ianm8/uPDCR/README.md

# uPDCR
A simple direct conversion receiver using the phasing method of image rejection. This is an evolution of the uDCR and the uDCR2 receivers. This radio tunes from 3.5 MHz to 15 MHz and receives signals modulated with LSB, USB or CW.

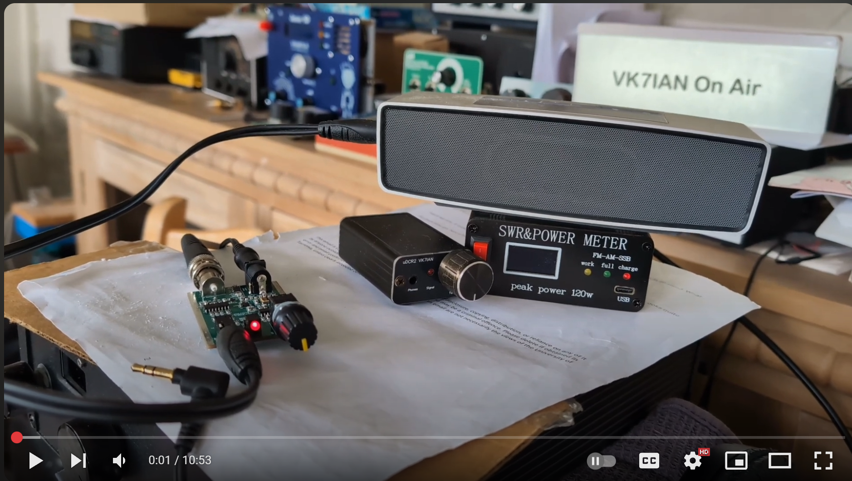
[picture p1: docs/uPDCR-Example-Video.png]
IMAGE ALT TEXT HERE (https://www.youtube.com/watch?v=nOgAh_WVSGE)
