ianm8/uPDCR/src/README.md

Build:
 * Board: Seeed XIAO RP2350 
 * CPU Speed: 240Mhz
 * Optimize: -O2
 * USB Stack: No USB
 * Flash Size: 2MB

Some history
 * Version 0.9 initial release
 * Version 1.0 fix random LSB/USB changes
 * Version 1.1 2025-03-26 improve band change muting
 * Version 1.2 2025-03-29 tweak to S-meter parameters
