ianm8/uPDCR/docs/uPDCR-Filter-PCB.jpg

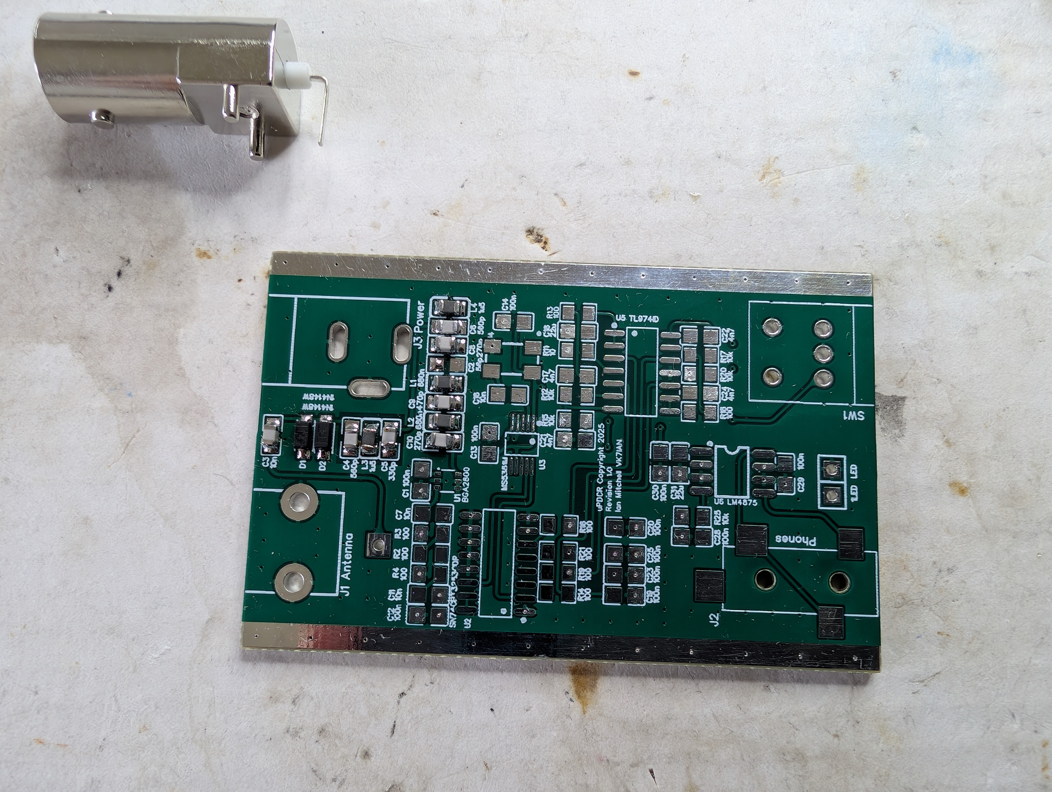
docs/uPDCR-Filter-PCB.jpg
