ianm8/uPDCR/docs/uPDCR-Filter-Response.jpg

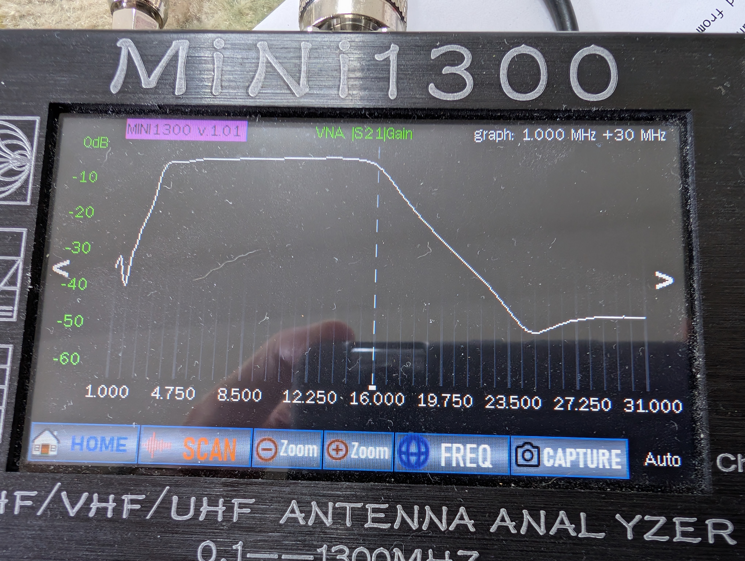
docs/uPDCR-Filter-Response.jpg
