ianm8/uPDCR/docs/uPDCR-QSD-DSO.jpg

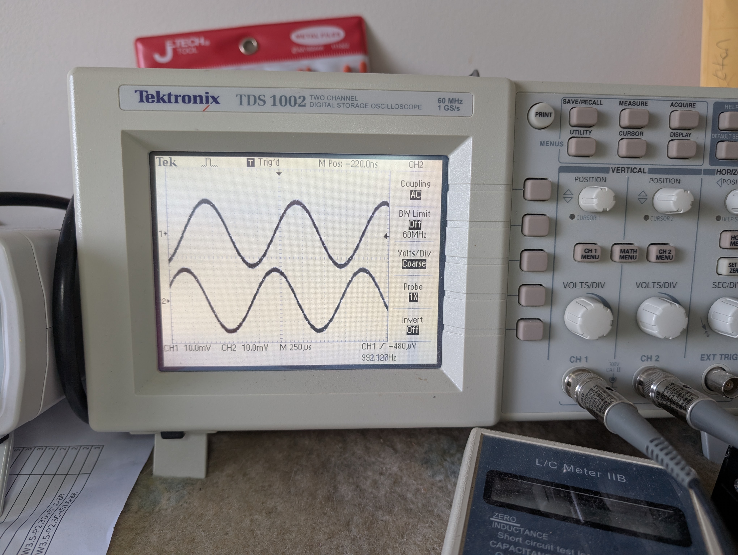
docs/uPDCR-QSD-DSO.jpg
