ianm8/uPDCR/docs/uPDCR-QSD-PCB.jpg

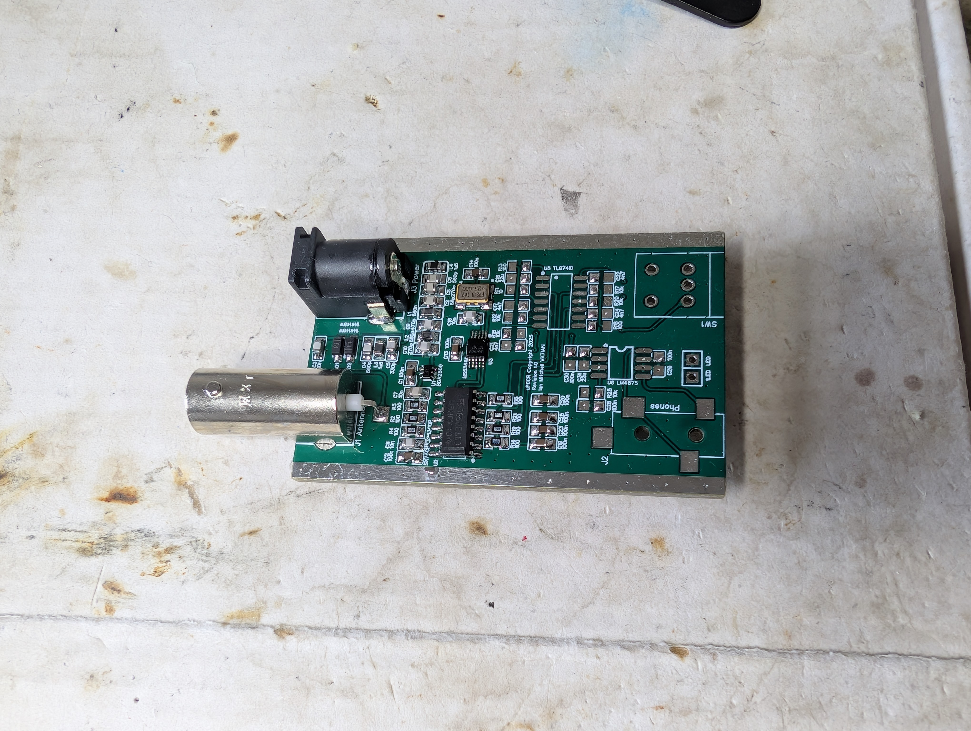
docs/uPDCR-QSD-PCB.jpg
