ianm8/uPDCR/docs/Schematic_uPDCR_2025-03-05.pdf

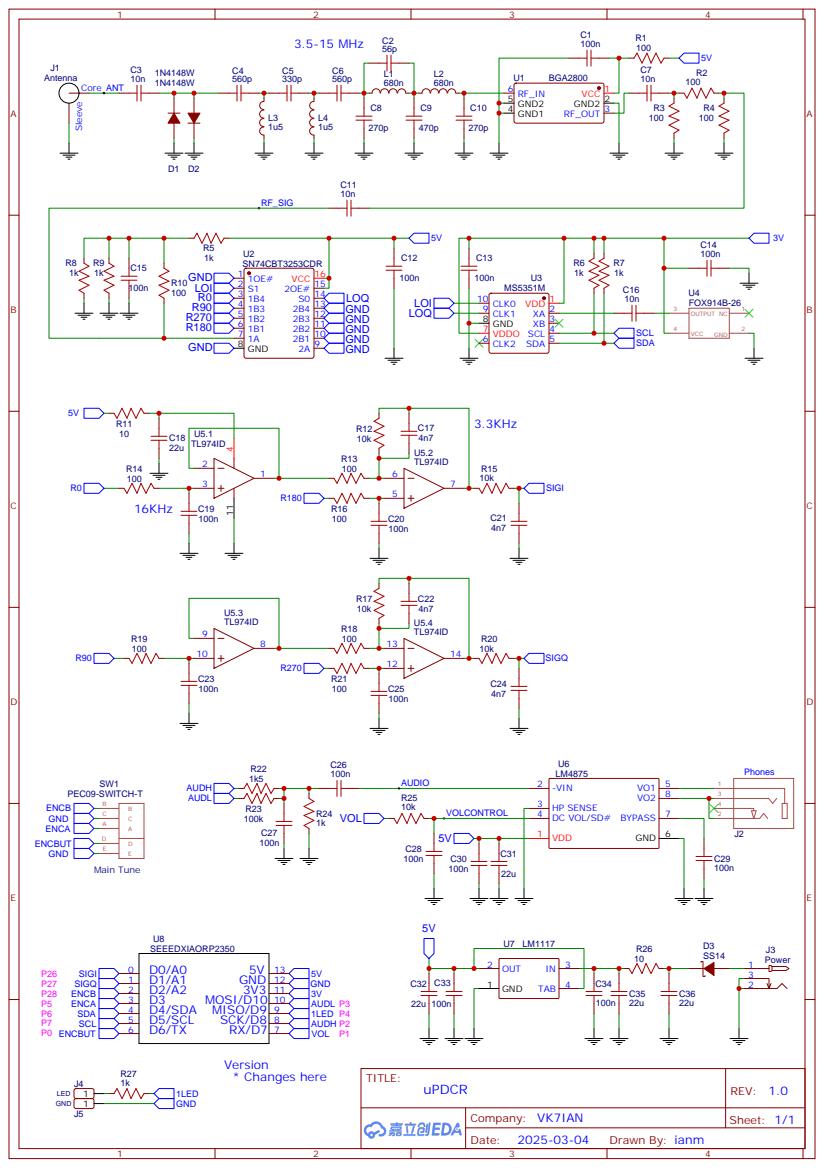
[picture p6: page 1]
