ianm8/uPDCR/src/filter.h

/*
 * uPDCR - Direct Conversion Receiver mk III
 *
 * Copyright (C) 2025 Ian Mitchell VK7IAN
 *
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
 * You should have received a copy of the GNU General Public License
 * along with this program.  If not, see <http://www.gnu.org/licenses/>.
 */

#ifndef FILTER_H
#define FILTER_H

#define FIR_LENGTH 256
#define __mac_tap(_h) acc += (_h)*x[i++]
#define __mac_zap(_h) i++
#define MA_FILTER_LENGTH 32u
#define MA_LOG2_LENGTH 5u
#define MA_FILTER_MASK (MA_FILTER_LENGTH-1u)

namespace FILTER
{
  static const float __not_in_flash_func(ma4fi)(const int16_t s)
  {
    // I channel
    // 4th order 16 pole moving average
    // (notch at 250,000/16 = 15625Hz)
    static float delay1[MA_FILTER_LENGTH] = { 0 };
    static float delay2[MA_FILTER_LENGTH] = { 0 };
    static float delay3[MA_FILTER_LENGTH] = { 0 };
    static float delay4[MA_FILTER_LENGTH] = { 0 };
    static float sum1 = 0;
    static float sum2 = 0;
    static float sum3 = 0;
    static float sum4 = 0;
    static uint8_t p = 0;
    const float v1 = (float)(s - 2048) / 2048.0f;
    sum1 = sum1 - delay1[p] + v1;
    delay1[p] = v1;
    const float v2 = sum1 / (float)MA_FILTER_LENGTH;
    sum2 = sum2 - delay2[p] + v2;
    delay2[p] = v2;
    const float v3 = sum2 / (float)MA_FILTER_LENGTH;
    sum3 = sum3 - delay3[p] + v3;
    delay3[p] = v3;
    const float v4 = sum3 / (float)MA_FILTER_LENGTH;
    sum4 = sum4 - delay4[p] + v4;
    delay4[p] = v4;
    p++;
    p &= MA_FILTER_MASK;
    return sum4 / (float)MA_FILTER_LENGTH;
  }

  static const float __not_in_flash_func(ma4fq)(const int16_t s)
  {
    // Q channel
    // 4th order 16 pole moving average
    // (notch at 250,000/16 = 15625Hz)
    static float delay1[MA_FILTER_LENGTH] = { 0 };
    static float delay2[MA_FILTER_LENGTH] = { 0 };
    static float delay3[MA_FILTER_LENGTH] = { 0 };
    static float delay4[MA_FILTER_LENGTH] = { 0 };
    static float sum1 = 0;
    static float sum2 = 0;
    static float sum3 = 0;
    static float sum4 = 0;
    static uint8_t p = 0;
    const float v1 = (float)(s - 2048) / 2048.0f;
    sum1 = sum1 - delay1[p] + v1;
    delay1[p] = v1;
    const float v2 = sum1 / (float)MA_FILTER_LENGTH;
    sum2 = sum2 - delay2[p] + v2;
    delay2[p] = v2;
    const float v3 = sum2 / (float)MA_FILTER_LENGTH;
    sum3 = sum3 - delay3[p] + v3;
    delay3[p] = v3;
    const float v4 = sum3 / (float)MA_FILTER_LENGTH;
    sum4 = sum4 - delay4[p] + v4;
    delay4[p] = v4;
    p++;
    p &= MA_FILTER_MASK;
    return sum4 / (float)MA_FILTER_LENGTH;
  }

  static float __not_in_flash_func(dc1)(const float in)
  {
    // single pole IIR high-pass filter
    //static const float k = 0.004f; // <100Hz
    //static const float k = 0.01f; // ~100Hz
    //static const float k = 0.1f; // ~300Hz
    static const float k = 0.05f; // ~200Hz
    static float s = 0;
    static float x1 = 0;
    static float y1 = 0;
    s -= x1;
    x1 = in;
    s += x1 - y1 * k;
    return (y1 = s);
  }

  static float __not_in_flash_func(dc2)(const float in)
  {
    // single pole IIR high-pass filter
    //static const float k = 0.004f; // <100Hz
    //static const float k = 0.01f; // ~100Hz
    //static const float k = 0.1f; // ~300Hz
    static const float k = 0.05f; // ~200Hz
    static float s = 0;
    static float x1 = 0;
    static float y1 = 0;
    s -= x1;
    x1 = in;
    s += x1 - y1 * k;
    return (y1 = s);
  }

  static const float __not_in_flash_func(ap1)(const float s)
  {
    // all pass 84 @ 31250
    // all pass 607 @ 31250
    // all pass 2539 @ 31250
    static const float k1 = 0.98325f;
    static const float k2 = 0.88497f;
    static const float k3 = 0.59331f;
    static float x1 = 0.0f;
    static float y1 = 0.0f;
    static float x2 = 0.0f;
    static float y2 = 0.0f;
    static float x3 = 0.0f;
    static float y3 = 0.0f;
    y1 = (k1 * (s + y1)) - x1;
    x1 = s;
    y2 = (k2 * (y1 + y2)) - x2;
    x2 = y1;
    y3 = (k3 * (y2 + y3)) - x3;
    x3 = y2;
    return y3;
  }

  static const float __not_in_flash_func(ap2)(const float s)
  {
    // all pass 8628 @ 31250
    // all pass 1200 @ 31250
    // all pass 287 @ 31250
    static const float k1 = 0.07102f;
    static const float k2 = 0.78470f;
    static const float k3 = 0.94391f;
    static float x1 = 0.0f;
    static float y1 = 0.0f;
    static float x2 = 0.0f;
    static float y2 = 0.0f;
    static float x3 = 0.0f;
    static float y3 = 0.0f;
    y1 = (k1 * (s + y1)) - x1;
    x1 = s;
    y2 = (k2 * (y1 + y2)) - x2;
    x2 = y1;
    y3 = (k3 * (y2 + y3)) - x3;
    x3 = y2;
    return y3;
  }

  static const float __not_in_flash_func(lpf_2400)(const float sample)
  {
    // 31250
    // 2400 Hz
    // att: 60dB
    // 255 taps
    static float x[FIR_LENGTH] = { 0.0f };
    static uint8_t sample_index = 0;
    uint8_t i = sample_index;
    x[sample_index--] = sample;
    float acc = 0;
    __mac_tap(-0.000051f);
    __mac_tap(-0.000052f);
    __mac_tap(-0.000039f);
    __mac_tap(-0.000011f);
    __mac_tap(0.000027f);
    __mac_tap(0.000067f);
    __mac_tap(0.000097f);
    __mac_tap(0.000109f);
    __mac_tap(0.000094f);
    __mac_tap(0.000051f);
    __mac_tap(-0.000013f);
    __mac_tap(-0.000086f);
    __mac_tap(-0.00015f);
    __mac_tap(-0.000186f);
    __mac_tap(-0.000181f);
    __mac_tap(-0.000129f);
    __mac_tap(-0.000036f);
    __mac_tap(0.00008f);
    __mac_tap(0.000194f);
    __mac_tap(0.000276f);
    __mac_tap(0.000301f);
    __mac_tap(0.000254f);
    __mac_tap(0.000137f);
    __mac_tap(-0.00003f);
    __mac_tap(-0.000211f);
    __mac_tap(-0.000364f);
    __mac_tap(-0.000446f);
    __mac_tap(-0.000428f);
    __mac_tap(-0.000302f);
    __mac_tap(-0.000087f);
    __mac_tap(0.000174f);
    __mac_tap(0.000424f);
    __mac_tap(0.000598f);
    __mac_tap(0.000646f);
    __mac_tap(0.000541f);
    __mac_tap(0.000292f);
    __mac_tap(-0.000054f);
    __mac_tap(-0.000424f);
    __mac_tap(-0.000729f);
    __mac_tap(-0.000889f);
    __mac_tap(-0.000849f);
    __mac_tap(-0.000599f);
    __mac_tap(-0.00018f);
    __mac_tap(0.000325f);
    __mac_tap(0.000799f);
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
    __mac_tap(-0.000116f);
    __mac_tap(-0.000084f);
    __mac_tap(-0.000056f);
    __mac_tap(-0.000032f);
    __mac_tap(-0.000013f);
    __mac_tap(0.000003f);
    __mac_tap(0.000015f);
    __mac_tap(0.000024f);
    __mac_tap(0.000029f);
    __mac_tap(0.000032f);
    return acc;
  }
}

#endif
